encukou/t3/(threads)

Thread 1 (2016-09-24):

Upper alignment pegs on the face interfere with button pads

encukou, 2016-09-24:
Workaround: Cut a bit off with a sharp knife

Closed 2016-10-05.

Thread 3 (2016-10-09):

Broken pipe on every button event

Glutexo, 2016-10-09:
Every button press/release in the emulator window raises a BrokenPipeError:

```
Traceback (most recent call last):
  File "_ctypes/callbacks.c", line 234, in 'calling callback function'
  File "/Users/Glutexo/Vývoj/t3/venv/lib/python3.5/site-packages/pyglet/libs/darwin/cocoapy/runtime.py", line 1121, in objc_method
    result = f(py_self, *args)
  File "/Users/Glutexo/Vývoj/t3/venv/lib/python3.5/site-packages/pyglet/window/cocoa/pyglet_view.py", line 151, in pygletKeyDown_
    self._window.dispatch_event('on_key_press', symbol, modifiers)
  File "/Users/Glutexo/Vývoj/t3/venv/lib/python3.5/site-packages/pyglet/window/__init__.py", line 1154, in dispatch_event
    if EventDispatcher.dispatch_event(self, *args) != False:
  File "/Users/Glutexo/Vývoj/t3/venv/lib/python3.5/site-packages/pyglet/event.py", line 355, in dispatch_event
    if handler(*args):
  File "/Users/Glutexo/Vývoj/t3/emu/t3emu.py", line 158, in on_key_press
    in_file.flush()
BrokenPipeError: [Errno 32] Broken pipe
```

Running using Python 3.5.2, Pyglet 1.2.4, Micropython 1.8.4 on macOS Sierra (10.12).

encukou, 2016-10-10:
This might mean that the MicroPython process crashed. Is there any error before this one?

Glutexo, 2016-10-11:
This one is raised upon start:

```
Traceback (most recent call last):
  File "main.py", line 169, in <module>
  File "t3.py", line 146, in run
  File "t3.py", line 144, in run
  File "t3.py", line 108, in _sys_task
  File "../emu/neopixel.py", line 20, in write
OSError: 45
```

Appears right after the `* b'92 39 58\n'` lines.

Glutexo, 2016-10-11:
And this one, right before `* b'# Fork started\n'`:

```
2016-10-11 07:32:28.238 Python[13547:478340] ApplePersistenceIgnoreState: Existing state will not be touched. New state will be written to /var/folders/07/lp6r0md134q3k__b45l9lg1h0000gn/T/org.python.python.savedState
```

encukou, 2016-10-11:
An internet search suggests 45 is "Operation not supported".
If you comment out `emu/neopixel.py:20` (`sys.stdout.flush()`), does it work?

Glutexo, 2016-10-11:
Yes. Commenting that out made the emulator work. Thanks!

Closed 2016-10-11.

Thread 4 (2016-10-24):

Game can’t be launched (no method ‹reset›)

Glutexo, 2016-10-24:
This error occurs upon launching any game:

```
Traceback (most recent call last):
  File "main.py", line 22, in <module>
  File "t3.py", line 155, in run
  File "t3.py", line 153, in run
  File "launcher.py", line 103, in main_menu
AttributeError: 'module' object has no attribute 'reset'
```

Happens since updating to the most recent revision.

encukou, 2016-10-24:
Will investigate. For a workaround, run `./t3 <name>` (e.g. `./t3 repeat`).

Glutexo, 2016-12-20:
Doesn’t happen to me any more. Don’t know why.

Closed 2016-12-20.

Thread 5 (2016-12-04):

Emulator hangs on first frame

Glutexo, 2016-12-04:
When run without parameters, the emulator launches, its screen appears, but nothing happens. The initial animation does not run. When run using a game name as a parameter, only the first frame of the game appears, but nothing happens then. The emulator does not respond to button presses. No error is written to the console.

Glutexo, 2016-12-04:
94a3a52 is the first broken revision.

encukou, 2016-12-05:
Interesting. I assume this is on Mac OS.

Will you be at Pyvo on Thursday so I could look at the bug?

Glutexo, 2016-12-07:
Sure, macOS 10.12.1, Python 3.5.2, Micropython 1.8.6, click 6.6, pyglet 1.2.4.

encukou, 2016-12-08:
It was a new MicroPython version, fixed in 4428e218bea1b66c67a79ac591927131dd14dd8f
Thanks for your time at the debugging session! :)

Closed 2016-12-08.

Thread 7 (2016-12-18):

wait_for_input gets confused on simultaneous presses

Glutexo, 2016-12-18:
When `t3.wait_for_input()` is used to capture input, the results get confused when more than one button is pressed at the same time. Then, upon a button press, different button presses/releases can be yielded.

Try this simple code:

```python
def main():
    i = 0
    while True:
        print('------', i)
        result = yield t3.wait_for_input()
        print(result)
        i += 1
```

Hold one button, press many others while still holding the first one. Press a button – the result can be different from the actually pressed button code. This state persists over subsequent presses as well.

encukou, 2017-01-04:
Thanks for the report!

Closed 2017-01-04.
