encukou/t3/sw/launcher_manifest.py

# Generated from: ['launcher_anims/tictac.png', 'launcher_anims/repeat.png', 'launcher_anims/dice.png']
data = (('tictac',
  ((200,
    b'\x00\x0f\x00\x00\x00\x00\x00\x00\x00\x00\x00\x00\x00\x00\x00\x00'
    b'\x00\x00\x00\x00\x00\x00\x00\x00\x00\x00\x00'),
   (200,
    b'\x00\x0f\x00\x00\x00\x00\x00\x00\x00\x00\x00\x00\x00\x0f\x00\x00'
    b'\x00\x00\x00\x00\x00\x00\x00\x00\x00\x00\x00'),
   (200,
    b'\x00\x0f\x00\x00\x00\x00\x00\x00\x00\x00\x00\x00\x00\x0f\x00\x00'
    b'\x00\x00\x00\x00\x00\x00\x00\x00\x00\x0f\x00'),
   (200,
    b'\x00\x00\x00\x00\x00\x00\x00\x00\x0f\x00\x00\x00\x00\x00\x00\x00'
    b'\x00\x00\x00\x00\x00\x00\x00\x00\x00\x00\x00'),
   (200,
    b'\x00\x00\x00\x00\x00\x00\x00\x00\x0f\x00\x00\x00\x00\x00\x0f\x00'
    b'\x00\x00\x00\x00\x00\x00\x00\x00\x00\x00\x00'),
   (200,
    b'\x00\x00\x00\x00\x00\x00\x00\x00\x0f\x00\x00\x00\x00\x00\x0f\x00'
    b'\x00\x00\x00\x00\x0f\x00\x00\x00\x00\x00\x00'),
   (200,
    b'\x00\x00\x00\x00\x0f\x00\x00\x00\x00\x00\x00\x00\x00\x00\x00\x00'
    b'\x00\x00\x00\x00\x00\x00\x00\x00\x00\x00\x00'),
   (200,
    b'\x00\x00\x00\x00\x0f\x00\x00\x00\x00\x00\x00\x00\x00\x0f\x00\x00'
    b'\x00\x00\x00\x00\x00\x00\x00\x00\x00\x00\x00'),
   (200,
    b'\x00\x00\x00\x00\x0f\x00\x00\x00\x00\x00\x00\x00\x00\x0f\x00\x00'
    b'\x00\x00\x00\x00\x00\x00\x0f\x00\x00\x00\x00'),
   (200,
    b'\x00\x00\x00\x00\x00\x00\x00\x00\x00\x00\x00\x00\x00\x00\x00\x00'
    b'\x00\x0f\x00\x00\x00\x00\x00\x00\x00\x00\x00'),
   (200,
    b'\x00\x00\x00\x00\x00\x00\x00\x00\x00\x00\x00\x00\x00\x00\x0f\x00'
    b'\x00\x0f\x00\x00\x00\x00\x00\x00\x00\x00\x00'),
   (200,
    b'\x00\x00\x00\x00\x00\x00\x00\x00\x00\x00\x00\x0f\x00\x00\x0f\x00'
    b'\x00\x0f\x00\x00\x00\x00\x00\x00\x00\x00\x00'))),
 ('repeat',
  ((200,
    b'\x00\x0f\x00\x00\x0f\x00\x00\x0f\x00\x00\x00\x00\x00\x0f\x00\x00'
    b'\x00\x00\x00\x00\x00\x00\x00\x00\x00\x00\x00'),
   (200,
    b'\x0f\x00\x00\x00\x00\x00\x00\x00\x00\x0f\x00\x00\x0f\x00\x00\x00'
    b'\x00\x00\x0f\x00\x00\x00\x00\x00\x00\x00\x00'),
   (200,
    b'\x00\x00\x00\x00\x00\x00\x00\x00\x00\x00\x00\x00\x00\x00\x0f\x00'
    b'\x00\x00\x00\x00\x0f\x00\x00\x0f\x00\x00\x0f'),
   (200,
    b'\x00\x00\x00\x00\x00\x00\x0f\x0f\x00\x00\x00\x00\x0f\x0f\x00\x0f'
    b'\x0f\x00\x00\x00\x00\x00\x00\x00\x0f\x0f\x00'))),
 ('dice',
  ((200,
    b'\x00\x00\x00\x00\x00\x00\x00\x00\x00\x00\x00\x00\x0f\x0f\x0f\x00'
    b'\x00\x00\x00\x00\x00\x00\x00\x00\x00\x00\x00'),
   (200,
    b'\x0f\x0f\x0f\x00\x00\x00\x00\x00\x00\x00\x00\x00\x00\x00\x00\x00'
    b'\x00\x00\x00\x00\x00\x00\x00\x00\x0f\x0f\x0f'),
   (200,
    b'\x0f\x0f\x0f\x00\x00\x00\x00\x00\x00\x00\x00\x00\x0f\x0f\x0f\x00'
    b'\x00\x00\x00\x00\x00\x00\x00\x00\x0f\x0f\x0f'),
   (200,
    b'\x0f\x0f\x0f\x00\x00\x00\x0f\x0f\x0f\x00\x00\x00\x00\x00\x00\x00'
    b'\x00\x00\x0f\x0f\x0f\x00\x00\x00\x0f\x0f\x0f'),
   (200,
    b'\x0f\x0f\x0f\x00\x00\x00\x0f\x0f\x0f\x00\x00\x00\x0f\x0f\x0f\x00'
    b'\x00\x00\x0f\x0f\x0f\x00\x00\x00\x0f\x0f\x0f'),
   (200,
    b'\x0f\x0f\x0f\x0f\x0f\x0f\x0f\x0f\x0f\x00\x00\x00\x00\x00\x00\x00'
    b'\x00\x00\x0f\x0f\x0f\x0f\x0f\x0f\x0f\x0f\x0f'))))
