encukou/t3/(commit log)

2016-09-12 Remove one of the battery compartments
    [t3.scad]
2016-09-12 Reposition speaker and remove magnet
    [t3.scad]
2016-09-12 Enlarge Speaker Hole
    [t3.scad]
2016-09-12 Shorten battery holder top, add space for a diode
    [t3.scad]
2016-09-12 Add holes for 5+2 pushbuttons
    [t3.scad]
2016-09-12 Enlarge screw holes above the base
    [t3.scad]
2016-09-12 Add button supports, move headers out of the way
    [t3.scad]
2016-09-12 Shorten the battery cover even more; add some embellishments
    [t3.scad]
2016-09-12 Add a display holder
    [t3.scad]
2016-09-12 Move the battery compartment 1mm up
    [t3.scad]
2016-09-12 Add a battery holder
    [t3.scad]
2016-09-12 Add a switch hole
    [t3.scad]
2016-09-12 Thicker walls around buttons
    [t3.scad]
2016-09-13 Adjust display holder
    [t3.scad]
2016-09-13 Fix the switch support
    [t3.scad]
2016-09-13 Rotate the buttons
    [t3.scad]
2016-09-13 Enlarge secondary screw holes
    [t3.scad]
2016-09-13 Make battery cover a tiny bit narrower
    [t3.scad]
2016-09-13 Add an ESP-12 support
    [t3.scad]
2016-09-15 Enlarge button holes a bit
    [t3.scad]
2016-09-15 Adjust switch hole
    [t3.scad]
2016-09-15 Lower the ESP-12 module
    [t3.scad]
2016-09-15 Make screw holes a bit smaller
    [t3.scad]
2016-09-15 Add one more wire to top battery cover, and add hole to guide wire out
    [t3.scad]
2016-09-15 Give some more space to the display
    [t3.scad]
2016-09-16 Redesign the wire paths in the battery cover
    [t3.scad]
2016-09-16 Rotate the ESP holder
    [t3.scad]
2016-09-16 Redesign bottom battery contact using a magnet
    [t3.scad]
2016-09-16 Enlarge the magnet holder
    [t3.scad]
2016-09-18 Redesign for larger batteries
    [flexbatter.scad, t3.scad]
2016-09-18 Face: Elnarge button holes
    [t3.scad]
2016-09-18 Face: Lower walls to fit
    [t3.scad]
2016-09-21 Face: Thicker button walls
    [t3.scad]
2016-09-23 3D: Add a battery/brain cover
    [t3.scad]
2016-09-23 SW: Emulate button IRQs
2016-09-23 3D: Face & cover: Reinforce the parts, and add alignment pegs
    [t3.scad]
2016-09-24 SW: Modify Dice to use the Button API
2016-09-24 SW: Add a button handler function
2016-09-24 3D: Provide clearance for screws
    [t3.scad]
2016-09-24 SW: Get rid of interrupts again
    [t3.scad]
2016-09-25 3D: Make alignment pegs for the face smaller
    Fixes https://github.com/encukou/t3/issues/1
    [t3.scad]
2016-09-25 3D: Fix the switch compartment
    [t3.scad]
2016-10-08 Use reset() from the launcher so memory is not wasted
    [launcher.py, main.py, splash.py]
2016-10-08 Map left button to pin 4 instead of 16
2016-10-12 Switch to Click for argument parsing
    The micropython binary can now be selected on the command line,
    or through an environment variable.
    Should help with https://github.com/encukou/t3/issues/2
    [t3emu.py]
2016-10-13 We now have “games”, plural!
2016-10-13 Use yields for getting button state, instead of button handlers
2016-10-15 Use a manifest module instead of cartridge headers for launcher menu
    Add a script to compile PNGs into byte sequences displayable on the
    T3 display.
    Load and use the result in the launcher, instead of examining files.
    This enables game modules to be compiled to bytecode -- an operation
    that loses comments.
    Also, bypass the provided Python wrapper for the NeoPixel driver.
    Docs pending.
2016-12-07 Fix micropython path on a mac.
    The `execvpe` function Mac uses $PATH from the *new* environment
    when looking for the binary, where Linux uses $PATH from the *existing*
    one.
    Copy the path from the existing dir to the new one.
    Fixes: https://github.com/encukou/t3/pull/6
    [t3emu.py]
2017-01-04 Emu: Handle the case of multiple buttons pressed/released together
    Fixes: https://github.com/encukou/t3/issues/7
    [machine.py]
2017-01-29 3d: Increase tolerance for button holes, and make it parametric
    [t3.scad]
